Mvalverde00/DLD-Dino/game-display.jpeg

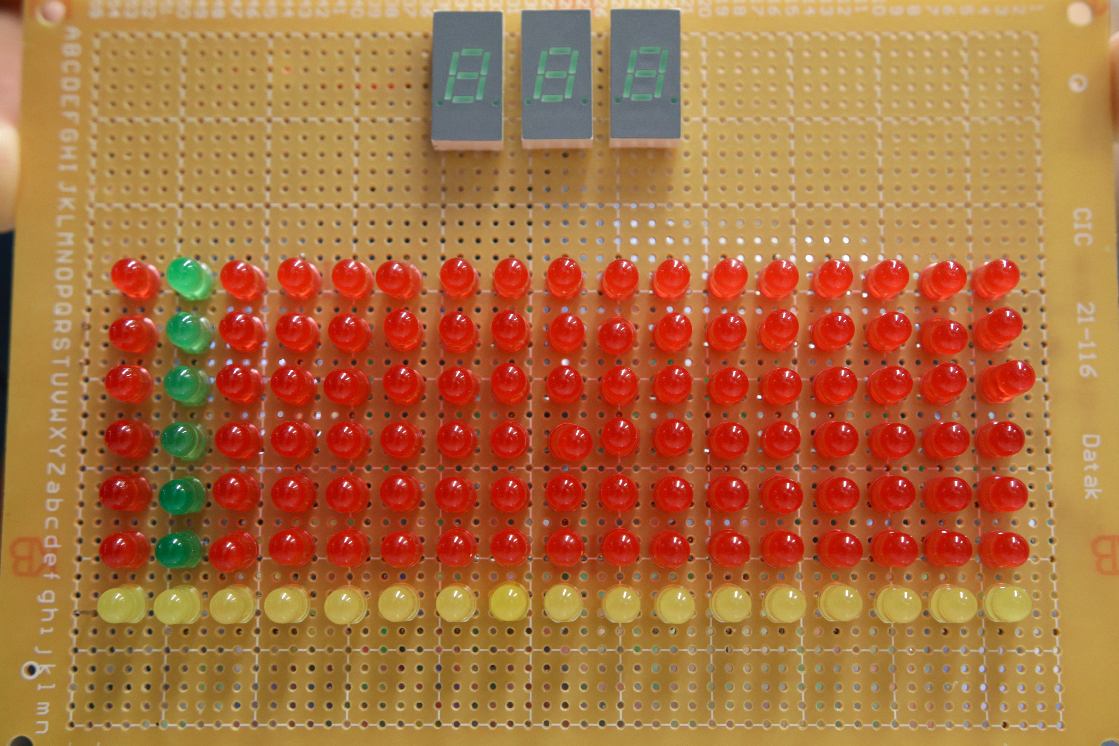
game-display.jpeg
