Mvalverde00/DLD-Dino/project-behind-the-scenes.jpg

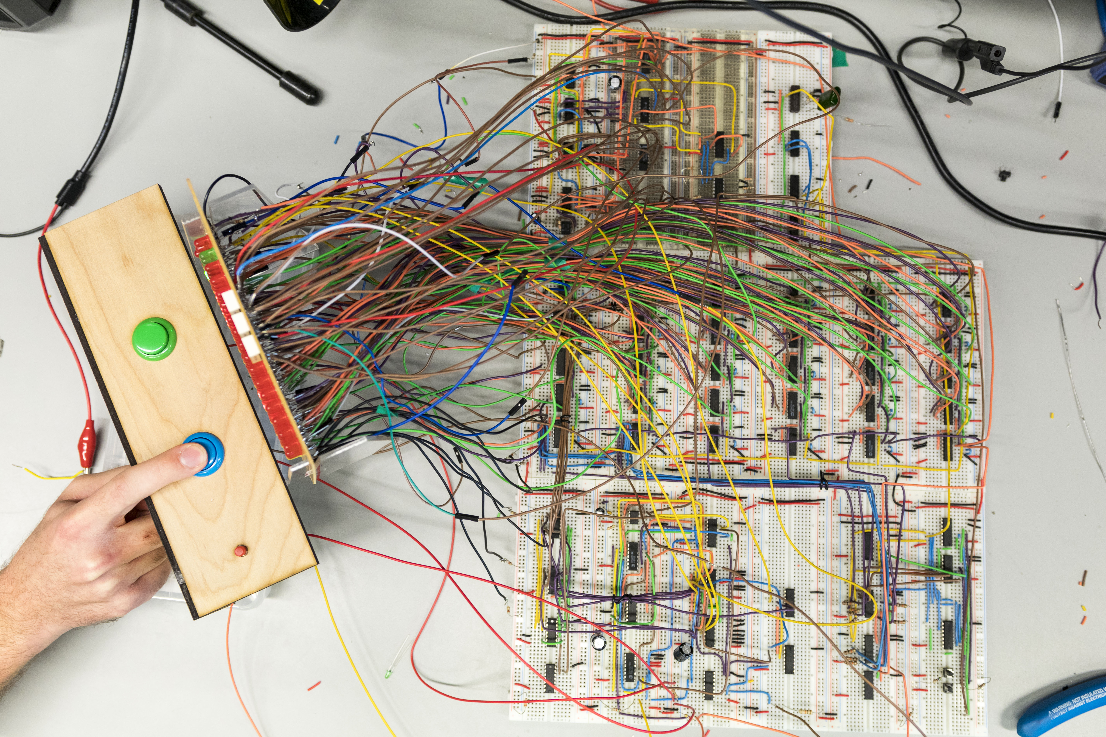
project-behind-the-scenes.jpg
