Mvalverde00/DLD-Dino/(list of files, drawings)

Other design files:
Jumping-plan.circ
